austinjoseph/EARS/Documents/Board Review.md

Notes for board review with C3 Team.

Remove "$" from item labels

Label J1 & J2

Check the reset line on the cortex for an internal pullup resistor

Fill in Info Boxes

Add P-Channel MOSFET

Change all lables

Ground Stitching

Add De-coupling caps
