austinjoseph/EARS/Documents/EARS High Level Diagram.png

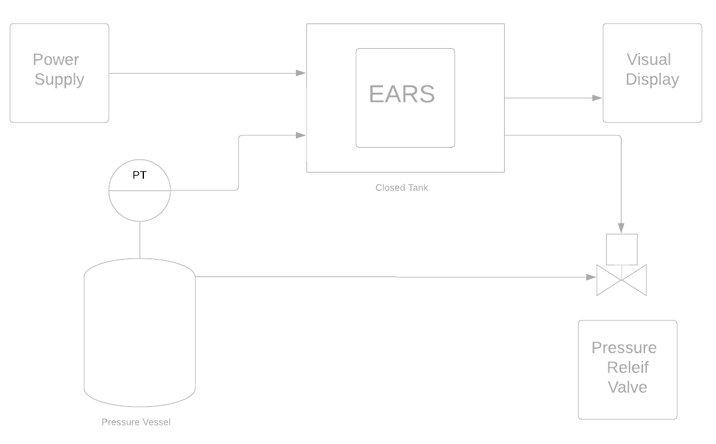
Documents/EARS High Level Diagram.png
