austinjoseph/EARS/Documents/MainLoop.PNG

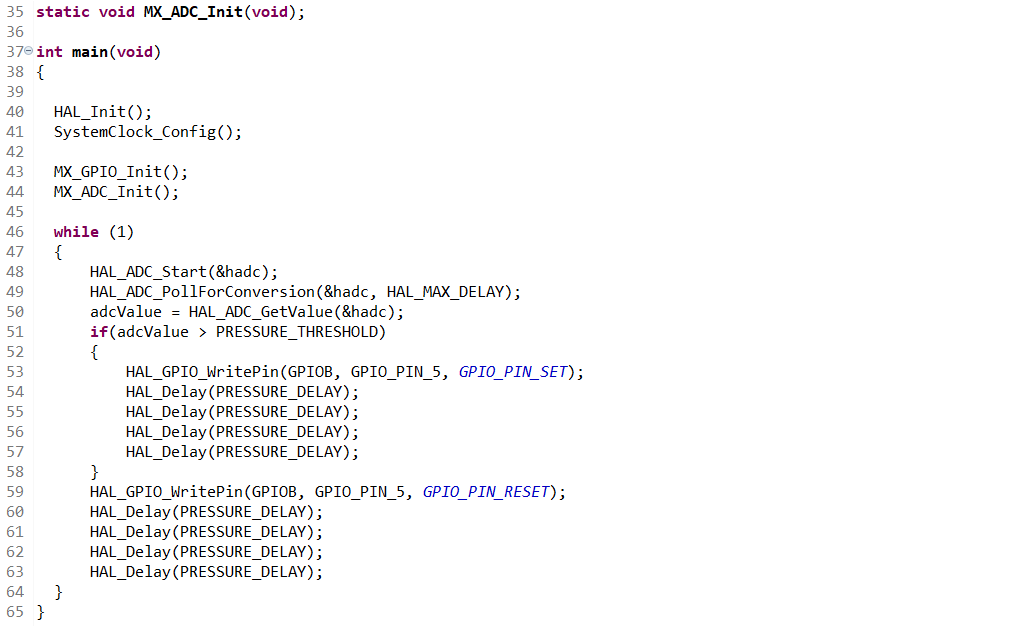
Documents/MainLoop.PNG
