austinjoseph/EARS/Documents/Top Level EARS Controller.png

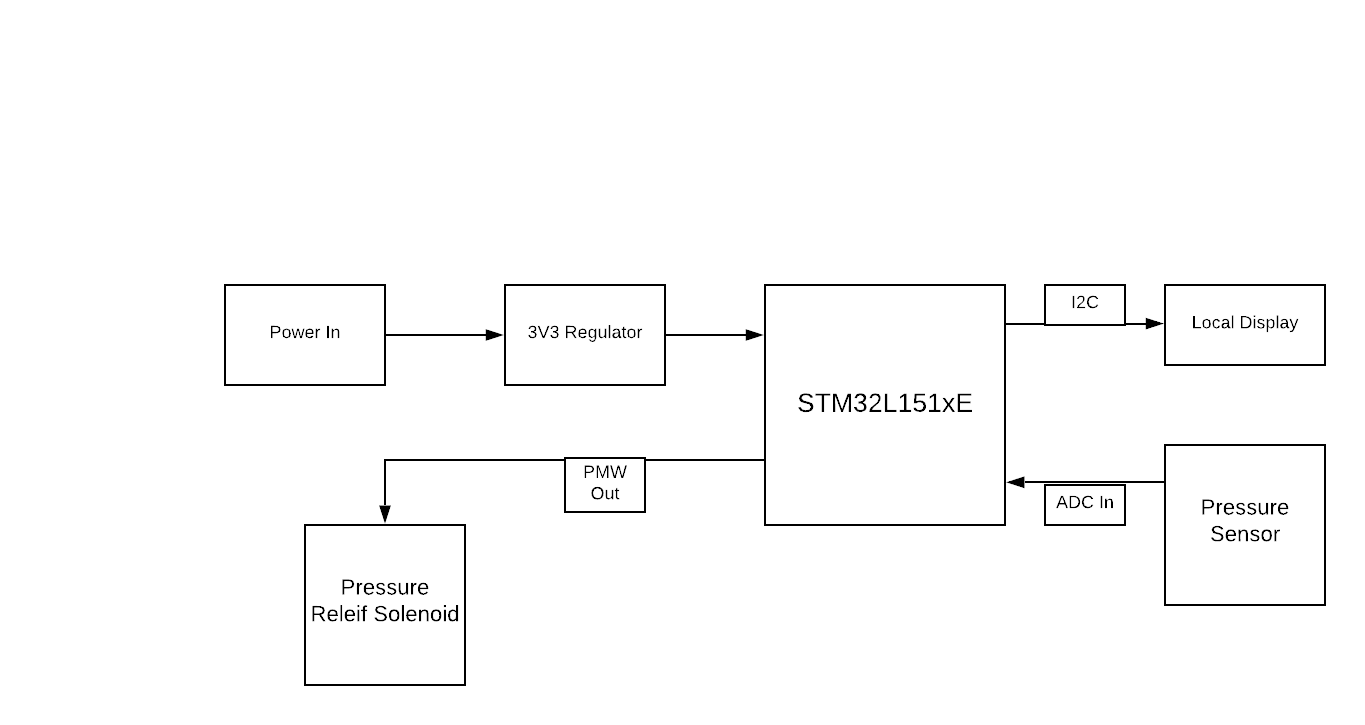
Documents/Top Level EARS Controller.png
