austinjoseph/EARS/Eagle/EARS_Brd.PNG

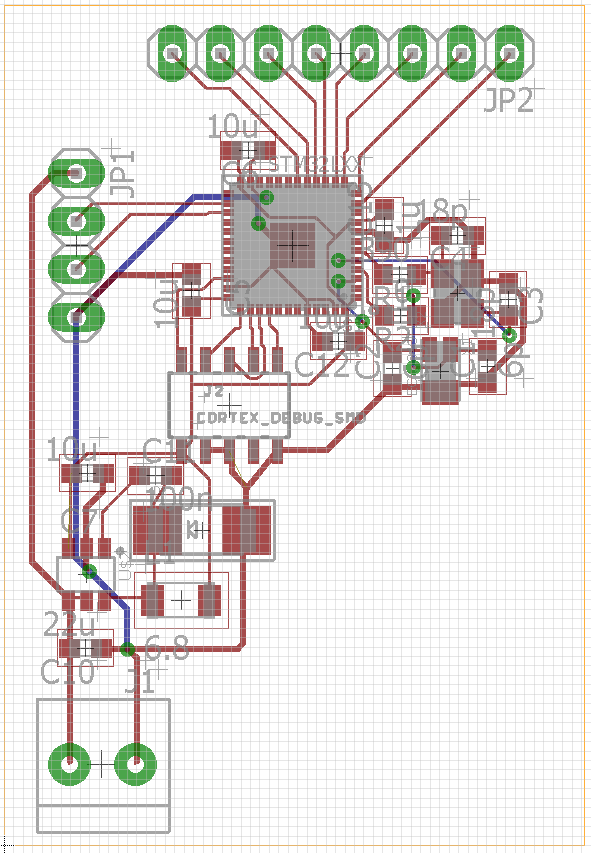
Eagle/EARS_Brd.PNG
