austinjoseph/EARS/Eagle/EARS_DC-DC_Regulator.PNG

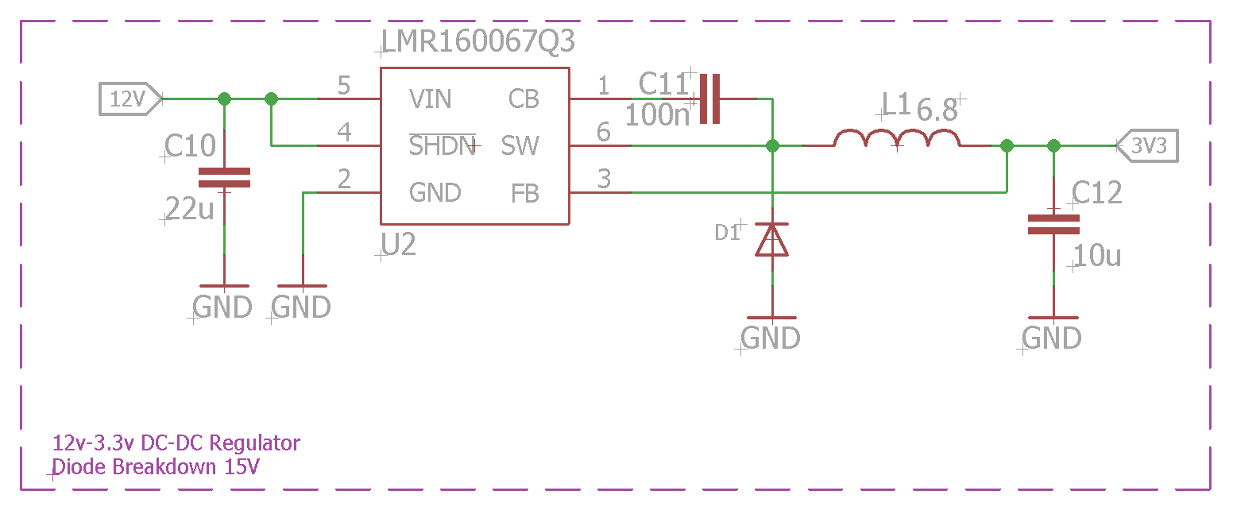
Eagle/EARS_DC-DC_Regulator.PNG
