austinjoseph/EARS/Eagle/EARS_MCU_Power_Supply.PNG

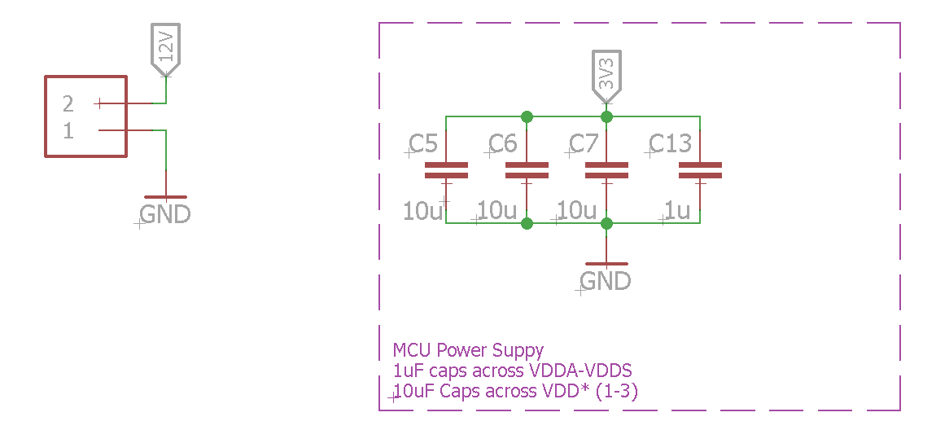
Eagle/EARS_MCU_Power_Supply.PNG
