austinjoseph/EARS/Eagle/EARS_Sch.PNG

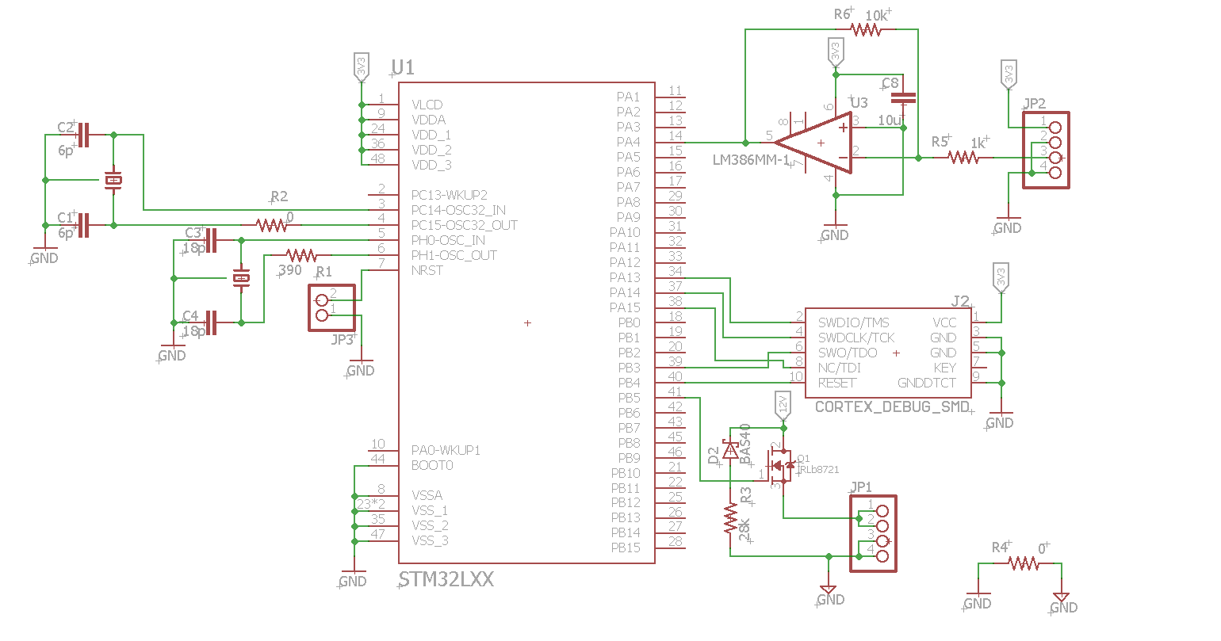
Eagle/EARS_Sch.PNG
