austinjoseph/EARS/Documents/EARS_BOM.xlsx

Description | Value | Footprint | MPN | DPN | Qty. | Total Qty. | Notes | Link
C1/C2 | 6pF | 0603 Imperal | ECJ-ZEC1E060D | PCC2108DKR-ND | 2 | 8 |  | https://www.digikey.com/product-detail/en/panasonic-electronic-components/ECJ-ZEC1E060D/PCC2108DKR-ND/574953
C3/C4 | 18pF | 0603 Imperal | CC0201JRNPO8BN180 | 311-3314-1-ND | 2 | 8 |  | https://www.digikey.com/product-detail/en/yageo/CC0201JRNPO8BN180/311-3314-1-ND/6818284
C5-C8/C12 | 10uF | 0603 Imperal | GRM0335C1H100JA01J | 490-17811-1-ND | 5 | 20 |  | https://www.digikey.com/product-detail/en/murata-electronics/GRM0335C1H100JA01J/490-17811-1-ND/8540047
C10 | 22uF | 0603 Imperal | GRM0335C1H220JA01D | 490-6123-1-ND | 1 | 4 |  | https://www.digikey.com/product-detail/en/murata-electronics/GRM0335C1H220JA01D/490-6123-1-ND/3845323
C11 | 100nF | 0603 Imperal | GRM033C81E104KE14D | 490-10403-1-ND | 1 | 4 |  | https://www.digikey.com/product-detail/en/murata-electronics/GRM033C81E104KE14D/490-10403-1-ND/5026280
C13 | 1uF | 0603 Imperal | GRM033R61A105ME15D | 490-13226-1-ND | 1 | 4 |  | https://www.digikey.com/product-detail/en/murata-electronics/GRM033R61A105ME15D/490-13226-1-ND/5877434
D1 |  | SMADIODE | SBRT3U45SA-13 | SBRT3U45SA-13DICT-ND | 1 | 4 | Could be overkill, 45V, 3A | https://www.digikey.com/product-detail/en/diodes-incorporated/SBRT3U45SA-13/SBRT3U45SA-13DICT-ND/4869050
D2 |  | SOT23 | CMPSH1-4 TR PBFREE | 1514-CMPSH1-4TRPBFREECT-ND | 1 | 4 | 40V 1.75A Flat lead, SOT23F | https://www.digikey.com/product-detail/en/central-semiconductor-corp/CMPSH1-4-TR-PBFREE/1514-CMPSH1-4TRPBFREECT-ND/4807059
J1 1x2-3.5mm | .1" | 1x2-3.5mm | 920-0172-01 | 1988-1163-ND | 1 | 1 | .1 pitch headers
JP1-3 | .1" | 1x04 | 920-0172-01 | 1988-1163-ND | 1 | 1 | .1 pitch headers | https://www.digikey.com/products/en/connectors-interconnects/rectangular-connectors-headers-male-pins/314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
J2 | .5" | SAMTECH_FISH-105-01 | FTSH-105-01-L-DV-K-TR | SAM13165CT-ND | 1 | 4 | SWDIO | https://www.digikey.com/product-detail/en/samtec-inc/FTSH-105-01-L-DV-K-TR/SAM13165CT-ND/8827920
L1 | 6.8uH | L3216C | AIML-1206-6R8K-T | 535-11675-1-ND | 1 | 4 |  | https://www.digikey.com/product-detail/en/abracon-llc/AIML-1206-6R8K-T/535-11675-1-ND/2782916
Q1 | IRLb8721 | T0220V | IRLB8721PBF | IRLB8721PBF-ND | 1 | 4 |  | https://www.digikey.com/products/en/discrete-semiconductor-products/transistors-fets-mosfets-single/278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
R1 | 390 | 0603 Imperal | RC0201FR-07390RL | YAG2283CT-ND | 1 | 4 |  | https://www.digikey.com/product-detail/en/yageo/RC0201FR-07390RL/YAG2283CT-ND/5252397
R2/4 | 0 | 0603 Imperal | ERJ-1GN0R00C | P15979CT-ND | 2 | 8 |  | https://www.digikey.com/product-detail/en/panasonic-electronic-components/ERJ-1GN0R00C/P15979CT-ND/3982319
R3 | 28k | 0603 Imperal | RC0201FR-0728KL | YAG2560CT-ND | 1 | 4 |  | https://www.digikey.com/product-detail/en/yageo/RC0201FR-0728KL/YAG2560CT-ND/5281424
R5 | 1k | 0603 Imperal | RC0201FR-071KL | 311-1KMCT-ND | 1 | 4 |  | https://www.digikey.com/product-detail/en/yageo/RC0201FR-071KL/311-1KMCT-ND/4340581
R6 | 10k | 0603 Imperal | RC0201FR-0710KL | 311-10.0KMCT-ND | 1 | 4 |  | https://www.digikey.com/product-detail/en/yageo/RC0201FR-0710KL/311-10.0KMCT-ND/1948976
U1 | STM32LXX | UFQFPN48 |  |  | 1 | 4 | 32Bit, 32KB Flash | https://www.digikey.com/product-detail/en/STM32L151C6U6/497-11486-ND/2734612?WT.z_slp_buy=stm_stm32l1
U2 | LMR160067Q3 | TI_SOT6 | LMR16006YDDCT | 296-38547-1-ND | 1 | 4 |  | https://www.digikey.com/product-detail/en/texas-instruments/LMR16006YDDCT/296-38547-1-ND/5034155
U3 | LM386MM-1 | MMSOP08 | LM386MM-1 | LM386MM-1TR-ND | 1 | 4 | NOT IN STOCK (on Digi Key) in stock on (online comps) | https://www.digikey.com/product-detail/en/texas-instruments/LM386MM-1/LM386MM-1TR-ND/270732 | https://www.onlinecomponents.com/national-semi/lm386mm1-11989240.html#
X1 | 32kHz | 3.2x1.5_SC | ECS-.327-6-34G-TR | XC2192CT-ND | 1 | 4 |  | https://www.digikey.com/product-detail/en/ecs-inc/ECS-.327-6-34G-TR/XC2192CT-ND/6578499
X2 | 8MHz | 3.2x2.5_SSC | FL0800011Q | FL0800011QDICT-ND | 1 | 4 | 8MHz Crystal (out of stock) added two possible replacments | https://www.digikey.com/product-detail/en/diodes-incorporated/FL0800011Q/FL0800011QDICT-ND/9952913 | https://www.digikey.com/product-detail/en/abracon-llc/ABM8AIG-8.000MHZ-8-V1R-T/535-15255-1-ND/10313805
 |  |  |  |  |  |  | I like this 2nd replacement better and has been ordred. |  | https://www.digikey.com/product-detail/en/ecs-inc/ECS-80-18-33-JGN-TR/50-ECS-80-18-33-JGN-CT-ND/10478765
