austinjoseph/EARS/Documents/EARS_BOM.PNG

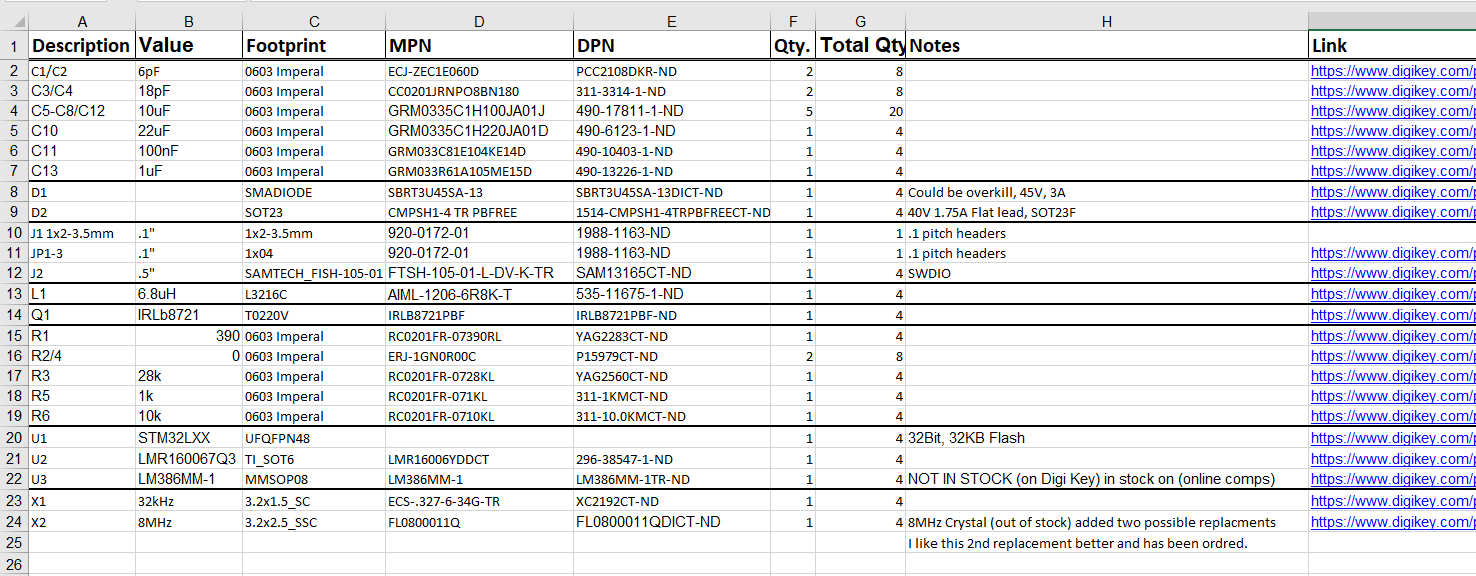
Documents/EARS_BOM.PNG
