austinjoseph/EARS/Eagle/EARS.brd

## EAGLE design Eagle/EARS.brd (2019-11-21)

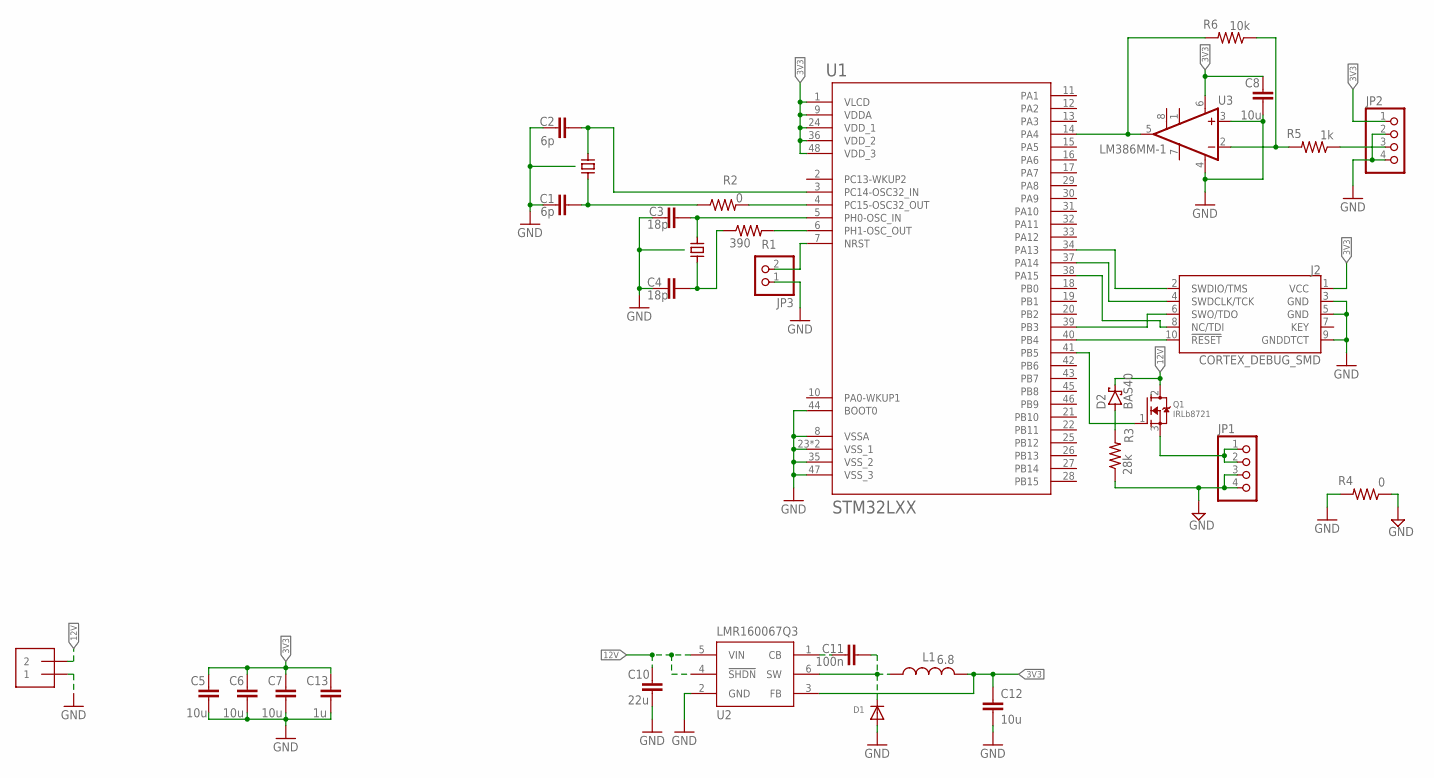
[picture p10: schematic EARS.sch]

Parts:
C1, C2: 6p; C0603
C3, C4: 18p; C0603
C5, C6, C7, C8, C12: 10u; C0603
C10: 22u; C0603
C11: 100n; C0603
C13: 1u; C0603
D1: DIODESMA; SMADIODE
D2: BAS40; SOT23
J1: 1X2-3.5MM
J2: CORTEX_DEBUG_SMD; SAMTECH_FTSH-105-01
JP1, JP2: PINHD-1X4; 1X04
JP3: PINHD-1X2; 1X02
L1: 6.8; L3216C
Q1: IRLb8721; TO220V
R1: 390; R0603
R2, R4: 0; R0603
R3: 28k; R0603
R5: 1k; R0603
R6: 10k; R0603
U1: STM32LXX; UFQFPN48
U2: LMR160067Q3; TI_SOT6
U3: LM386MM-1; MMSOP08
X1: ECX_34G; 3.2X1.5_SC
X2: FL0800011Q; 3.2X2.5_SSC

Connections:
3V3: C5.2, C6.2, C7.2, C8.2, C12.1, C13.2, J2.1 (VCC), JP2.1, L1.2, U1.1 (VLCD), U1.9 (VDDA), U1.24 (VDD_1), U1.36 (VDD_2), U1.48 (VDD_3), U2.3 (FB), U3.6 (VS)
8M0X_OUT: C4.2, R1.1, X2.3 (C2)
8MOX_IN: C3.2, U1.5 (PH0-OSC_IN), X2.1 (C1)
12V: C10.2, D2.3 (C), J1.2, Q1.2 (D), U2.4 (!SHDN!), U2.5 (VIN)
!RESET!: J2.10 (!RESET), U1.40 (PB4)
AGND: JP1.3, JP1.4, R3.1, R4.1
FB: R5.2, R6.1, U3.2 (-IN)
FLYBACK: D2.1 (A), R3.2
GND: C1.1, C2.1, C3.1, C4.1, C5.1, C6.1, C7.1, C8.1, C10.1, C12.2, C13.1, D1.A, J1.1, J2.3 (GND), J2.5 (GND), J2.9 (GNDDTCT), JP2.2, JP2.4, JP3.1, R4.2, U1.8 (VSSA), U1.23 (VSS_1), U1.35 (VSS_2), U1.44 (BOOT0), U1.47 (VSS_3), U1.T1 (VSS_1), U2.2 (GND), U3.3 (+IN), U3.4 (GND), X1.GND, X2.2, X2.4
LMR_CB: C11.1, U2.1 (CB)
LMR_SW: C11.2, D1.C, L1.1, U2.6 (SW)
MCU_P4: R2.2, U1.4 (PC15-OSC32_OUT)
MCU_P6: R1.2, U1.6 (PH1-OSC_OUT)
NC: J2.8 (NC/TDI), U1.38 (PA15)
NPN: JP1.1, JP1.2, Q1.3 (S)
NPN_DRV: Q1.1 (G), U1.41 (PB5)
NRST: JP3.2, U1.7 (NRST)
OSC32_IN: C1.2, R2.1, X1.C2
OSC32_OUT: C2.2, U1.3 (PC14-OSC32_IN), X1.C1
PRESSURE: R6.2, U1.14 (PA4), U3.5 (OUT)
PRSR_IN: JP2.3, R5.1
SWDCLK: J2.4 (SWDCLK/TCK), U1.37 (PA14)
SWDIO: J2.2 (SWDIO/TMS), U1.34 (PA13)
SWO: J2.6 (SWO/TDO), U1.39 (PB3)

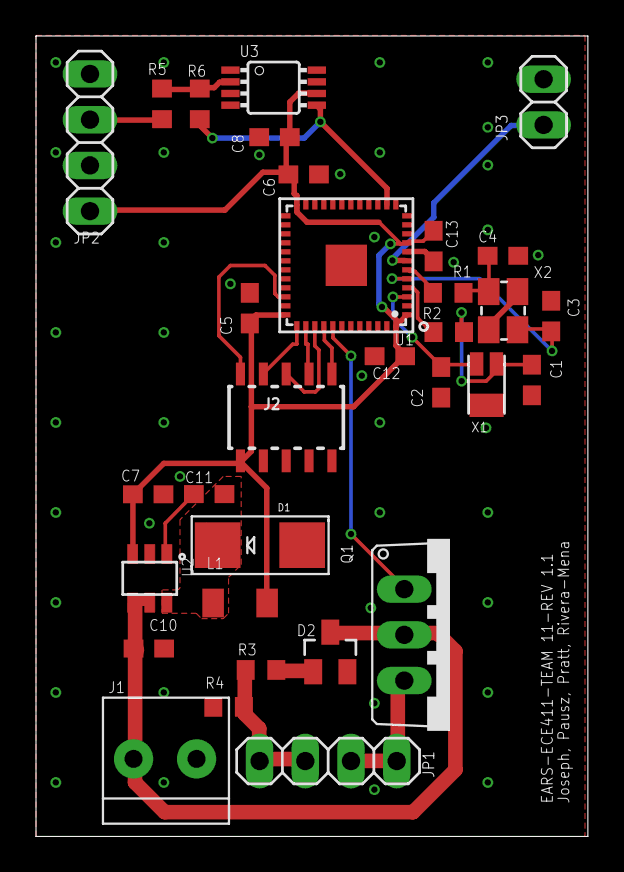
[picture p11: board EARS.brd from above]

Board: 2 copper layers, 30.7 x 44.5 mm, 32 parts (0 on the bottom side), 24 nets.
