austinjoseph/EARS/Firmware/EARS.ioc

Mcu.UserName=STM32L151C6Ux
PA13.Signal=SYS_JTMS-SWDIO
PA14.Signal=SYS_JTCK-SWCLK
PA15.Signal=SYS_JTDI
PA4.Signal=ADC_IN4
PB3.Signal=SYS_JTDO-TRACESWO
PB4.Signal=SYS_JTRST
PB5.Signal=GPIO_Output
PC14-OSC32_IN.Signal=RCC_OSC32_IN
PC15-OSC32_OUT.Signal=RCC_OSC32_OUT
PH0-OSC_IN.Signal=RCC_OSC_IN
PH1-OSC_OUT.Signal=RCC_OSC_OUT
