austinjoseph/EARS/(commit log)

2019-10-21 Added, Directories, BOM, Datasheets.
    [EARS_BOM.xlsx]
2019-10-31 Create Parts & URLs
    Working directory for keeping track of the parts used in the Schematic.
2019-10-31 Add files via upload
    Initial Schematic for the EARS board.
    [EARS.sch]
2019-10-31 Add files via upload
    Added step down regulator to Schematic.
    [EARS.sch]
2019-11-07 Initial Layout, fixed schematic.
    [EARS.brd, EARS.sch]
2019-11-07 Included eagle library, moved eagle files to eagle directory.
    [EARS.brd, EARS.sch]
2019-11-14 EARS Controller
    Top Level EARS Controller Board.
2019-11-20 Worked on board layout and wire routing.
    [EARS.sch]
2019-11-21 Added text to identify the board.
    [EARS.brd]
2019-11-21 Create Board Review.md
    Notes from our board review session with the C3 Team.
2019-11-21 Fixed schematics, added sense circuitry, added solenoid switch circuitry. Finished layout Rev 1.1
    [EARS.brd, EARS.sch]
2019-11-21 C6git statusgit status1git status
    [EARS.brd]
2019-11-21 Fixed Silk Screen
    [EARS.brd, EARS.sch]
2019-11-22 Added Parts From Schematic
    Some parts are still missing and there are a few I was unsure of the specs or how to find. Anything I was unsure of I put in the notes section. There were also a few parts that are out of stock so we might need to slightly change them or find them from a different supplier.
    [EARS_BOM.xlsx]
2019-11-27 Updated BOM
    Found the correct size caps and most other parts as well. Still missing 3 parts and 1 or 2 that might not be exactly the right part.
    [EARS_BOM.xlsx]
2019-11-27 Cleared up value issues, added links for missing parts.
    [EARS_BOM.xlsx]
2019-12-03 Updated BOM
    Still missing 22uF caps we need 4, could not find any 0603s or smaller anywhere.
    [EARS_BOM.xlsx]
2019-12-11 Organized and Finalized BOM
    [EARS_BOM.xlsx]
2019-12-11 Pic of BOM
2019-12-11 Board Pic
